skymuster/ROR_Automation/ROR Automation Control System.pdf

## ROR Control Box

## Operation

There are 3 separate control mechanisms:

### 1. Manual (via locally wired control panel)

- Open/Close button and Emergency stop buttons situated on a control panel inside the observatory.
- Telescope on/off button controls a relay that turns on power to the telescope equipment.
- LEDs represent status of roof (open/closed/moving/lost), telescope mount (safe/unsafe) and telescope equipment (on/off).

### 2. HTTP (over WiFi)

- Controlled via HTTP calls (GET/POST) over Wi-Fi connection between ESP32 and miniPC.
- Can be integrated into N.I.N.A. / SGP imaging sequence to automatically open/close roof at beginning and end of imaging sessions, or when weather requires, using PowerShell script to invoke the HTTP call.

### 3. Serial (wired serial UART connection)

- Controlled via a wired serial connection between ESP32 and miniPC using UART pins on ESP32. On miniPC a CP2102 USB to serial adapter module is used as this allows longer cable runs than possible with a standard USB cable.
- The ASCOM Rolling Roof Computer Interface (RRCI) by Chuck Faranda is used on the miniPC to send and receive serial commands to the ESP32.

### 4. Home Assistant (via MQTT over WiFi)

- Controlled using MQTT via WiFi connection between ESP32 and MQTT broker running on Home Assistant server.
- Allows Home Assistant to monitor and control roof operation via smart switches, phone apps and touchscreens.
Notes:
- All 4 mechanisms only allow roof movement when telescope is “safe” (i.e. RA & DEC axes are parked in safe position, as measured by external reed switches on mount.
- A local buzzer will sound if roof movement is not allowed.
- LEDs on control panel provide visual indicators of roof and telescope status. To reduce the number of wires running between the User Interface Panel and the ROR Control Box (and allow a CAT6 cable to be used), a 74HC595 shift register is integrated into the user interface panel to control all the local LEDs. This allows up to 8 LEDs be controlled using just 5 wires. The remaining 3 wires carry the pushbutton switch signals. Similarly, a 74HC165 shift register is used to multiplex the button commands onto a single data wire.

## User Interface Panel

## ESP32 Microcontroller

## Home Assistant Server

Telescope
Safety Status

= Safe

= Unsafe

Roof
Control

OPEN/
CLOSE

STOP

## MQTT Broker

MQTT over Wi-Fi

DEC-axis safety sensor (reed switch) RA-axis safety sensor (reed switch)

Roof closed sensor (reed switch)

Roof open sensor (reed switch)

Roof motor drive commands

1

2

3

## ESP32 GPIO Pinout:

# Buzzer Toggle (Open/Close/Stop)

Emergency Stop

# Roll-off Roof Automation Control System

## Telescope Mini-PC

N.I.N.A.

HTTP (GET/POST) over Wi-Fi

PowerShell
Script

Roof
Status

= Open

= Moving

= Closed

ASCOM

USB to Serial
adapter

TX RX

Serial Connection (UART)

Telescope Power (on/off)

Telescope
Control

= Power On

On /
Off

4

1

3 2
4

CAT6 cable

CAT6 cable

Observatory
Lights

MAX

DIM

OFF

VCC | 3V3 | GND
| EN | 23 | {not used, available}
| 36 | 22 | {not used, available}
| 39 | TX
DON'T USE | 34 | RX
DON'T USE | 35 | 21 | RELAY_OSC
RA_SWITCH | 32 | GND | RELAY_GND
DEC_SWITCH | 33 | 19 | RELAY_PWR
BUZZER_PIN | 25 | 18 | RELAY_STOP
SR_LATCH | 26 | 5 | ROOF_CLOSED_SENSOR
SR_CLOCK | 27 | 17 | UART_SERIAL_TX
SR_DATA_165 | 14 | 16 | UART_SERIAL_RX
SR_DATA_595 | 12 | 4 | ROOF_OPEN_SENSOR
GND | GND | 0 | DON'T USE
{not used, available} | 13 | 2 | {not used, available}
| D2 | 15 | DON'T USE
| D3 | D1
| CMD | D0
Power In | 5V | CLK

ESP32-WROOM

GPIO Pin Type:

INPUT_PULLUP
INPUT
OUTPUT

# Wiring Diagram: User Interface Panel

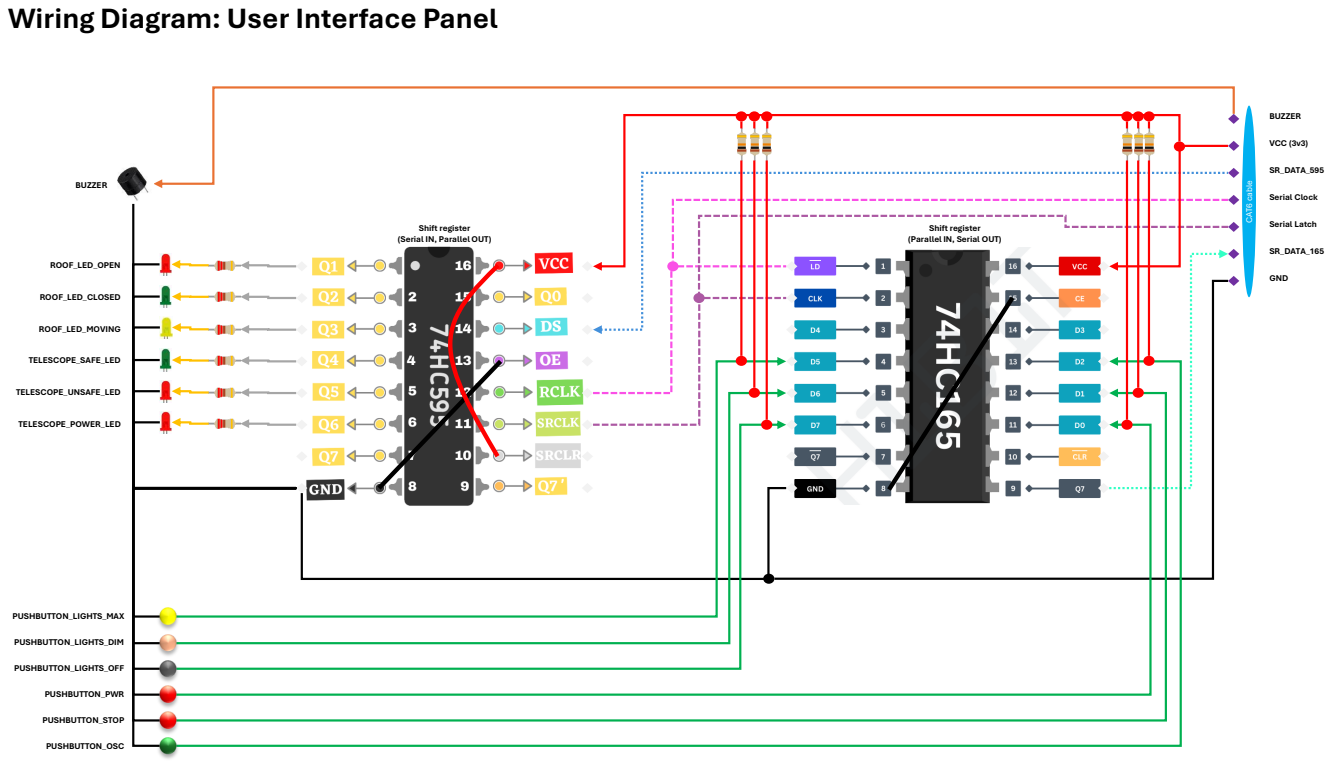
[picture p1: page 2]
Serial Latch; SR_DATA_595; Serial Clock; SR_DATA_165; VCC (3v3); GND; ROOF_LED_CLOSED; ROOF_LED_MOVING; ROOF_LED_OPEN; TELESCOPE_SAFE_LED; TELESCOPE_UNSAFE_LED; TELESCOPE_POWER_LED; BUZZER; CAT6 cable; PUSHBUTTON_PWR; PUSHBUTTON_STOP; PUSHBUTTON_OSC; PUSHBUTTON_LIGHTS_OFF; PUSHBUTTON_LIGHTS_DIM; PUSHBUTTON_LIGHTS_MAX

Shift register
(Serial IN, Parallel OUT)

(Parallel IN, Serial OUT)

# PCB Layout: User Interface Panel

## Roof

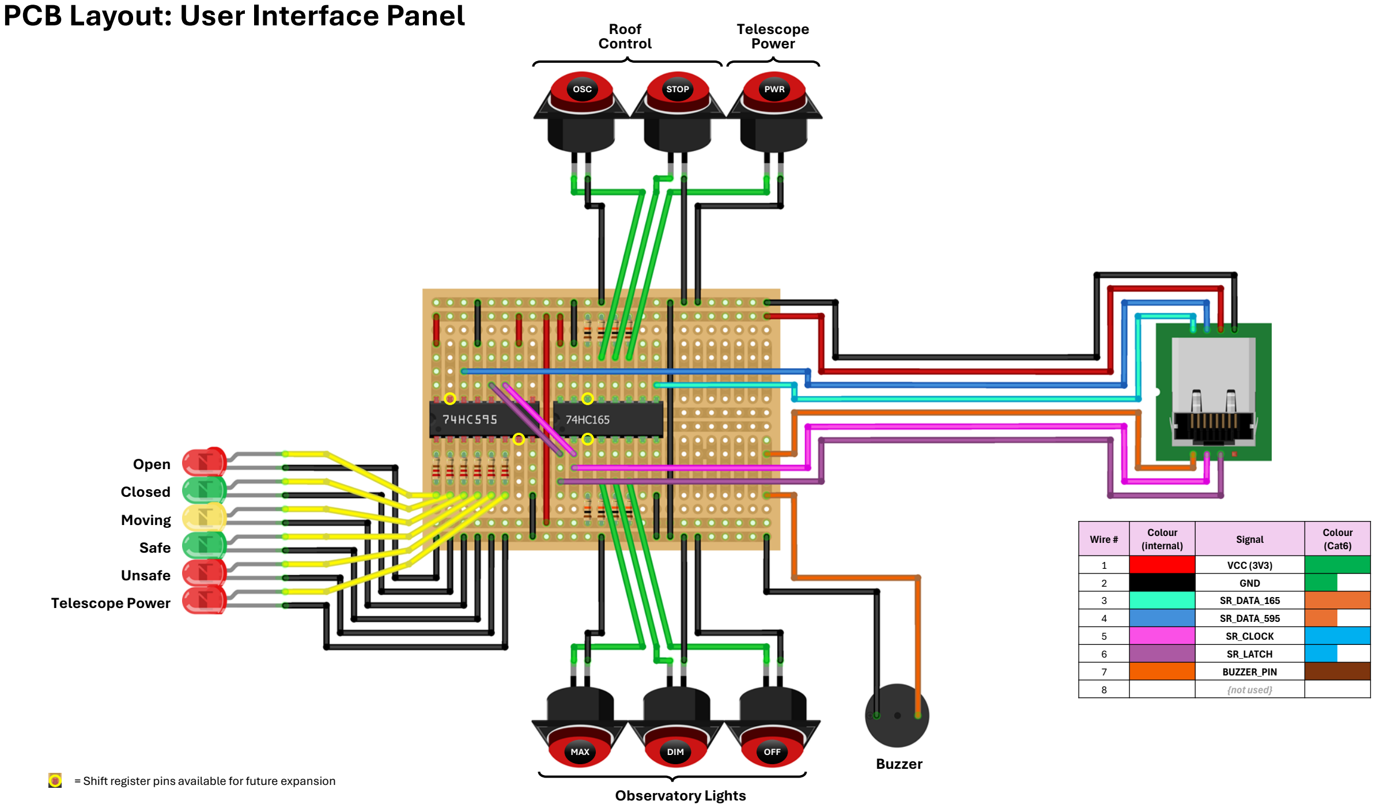
[picture p2: page 3]

Wire # | (internal) Colour | Signal | Colour (Cat6)
1 | | VCC (3V3)
2 | | GND
3 | | SR_DATA_165
4 | | SR_DATA_595
5 | | SR_CLOCK
6 | | SR_LATCH
7 | | BUZZER_PIN
8 | | {not used}
OSC | STOP | PWR

## Control

## Telescope Power

## Open Closed Moving Safe Unsafe Telescope Power

## Buzzer

## Observatory Lights

MAX | DIM | OFF

= Shift register pins available for future expansion

# Wiring Diagram: ROR Control Box

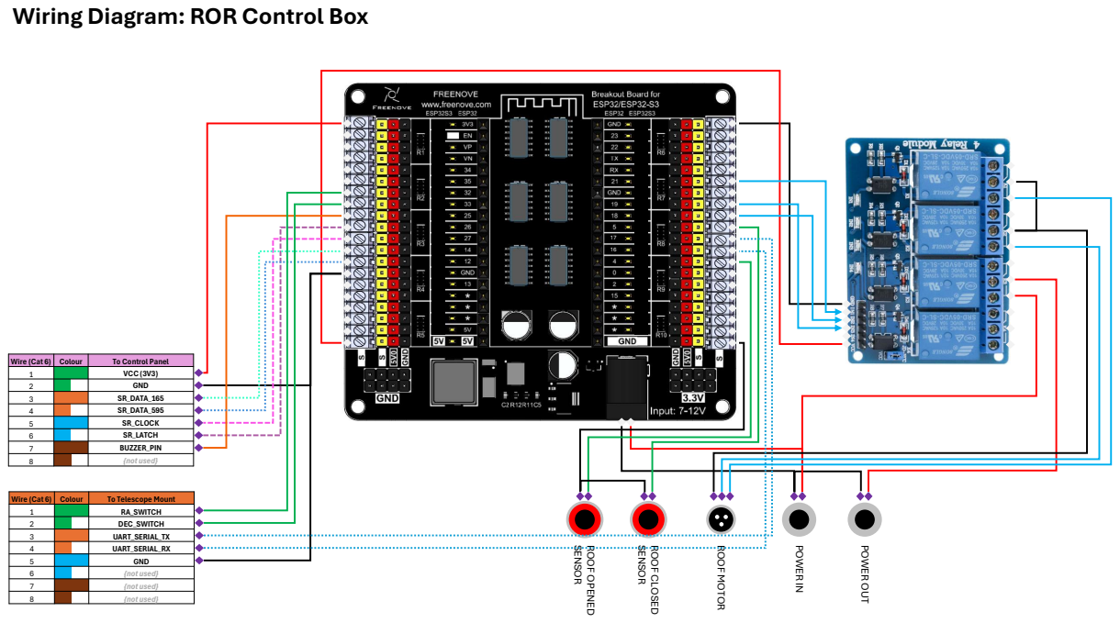
[picture p3: page 4]
SENSOR; ROOF OPENED; ROOF CLOSED; ROOF MOTOR; POWER IN; POWER OUT

Wire (Cat 6) | Colour | To Control Panel
1 | | VCC (3V3)
2 | | GND
3 | | SR_DATA_165
4 | | SR_DATA_595
5 | | SR_CLOCK
6 | | SR_LATCH
7 | | BUZZER_PIN
8 | | {not used}

Wire (Cat 6) | Colour | To Telescope Mount
1 | | RA_SWITCH
2 | | DEC_SWITCH
3 | | UART_SERIAL_TX
4 | | UART_SERIAL_RX
5 | | GND
6 | | {not used}
7 | | {not used}
